svenssonjoel/Z-SIM/firmware/README.md

# README

1. run the setup-submodules script

# Building

1. make        : build LispBM and Z-SIM firmware
2. make flash  : Program onto MCU

# Serial terminal

1. sudo screen /dev/ttyACM0   (or ttyACM1 etc)

#Lisp Interpreter Commands

1. (dcdc-enable)   : enable dcdc buck converter
2. (dcdc-disable)  : disable dcd buck converter 
3. (vsel-set n)    : set vsel bits, n is five bit number
