svenssonjoel/Z-SIM/sp_z_sim.kicad_pcb

## KiCad design sp_z_sim.kicad_pcb (2019-12-05)

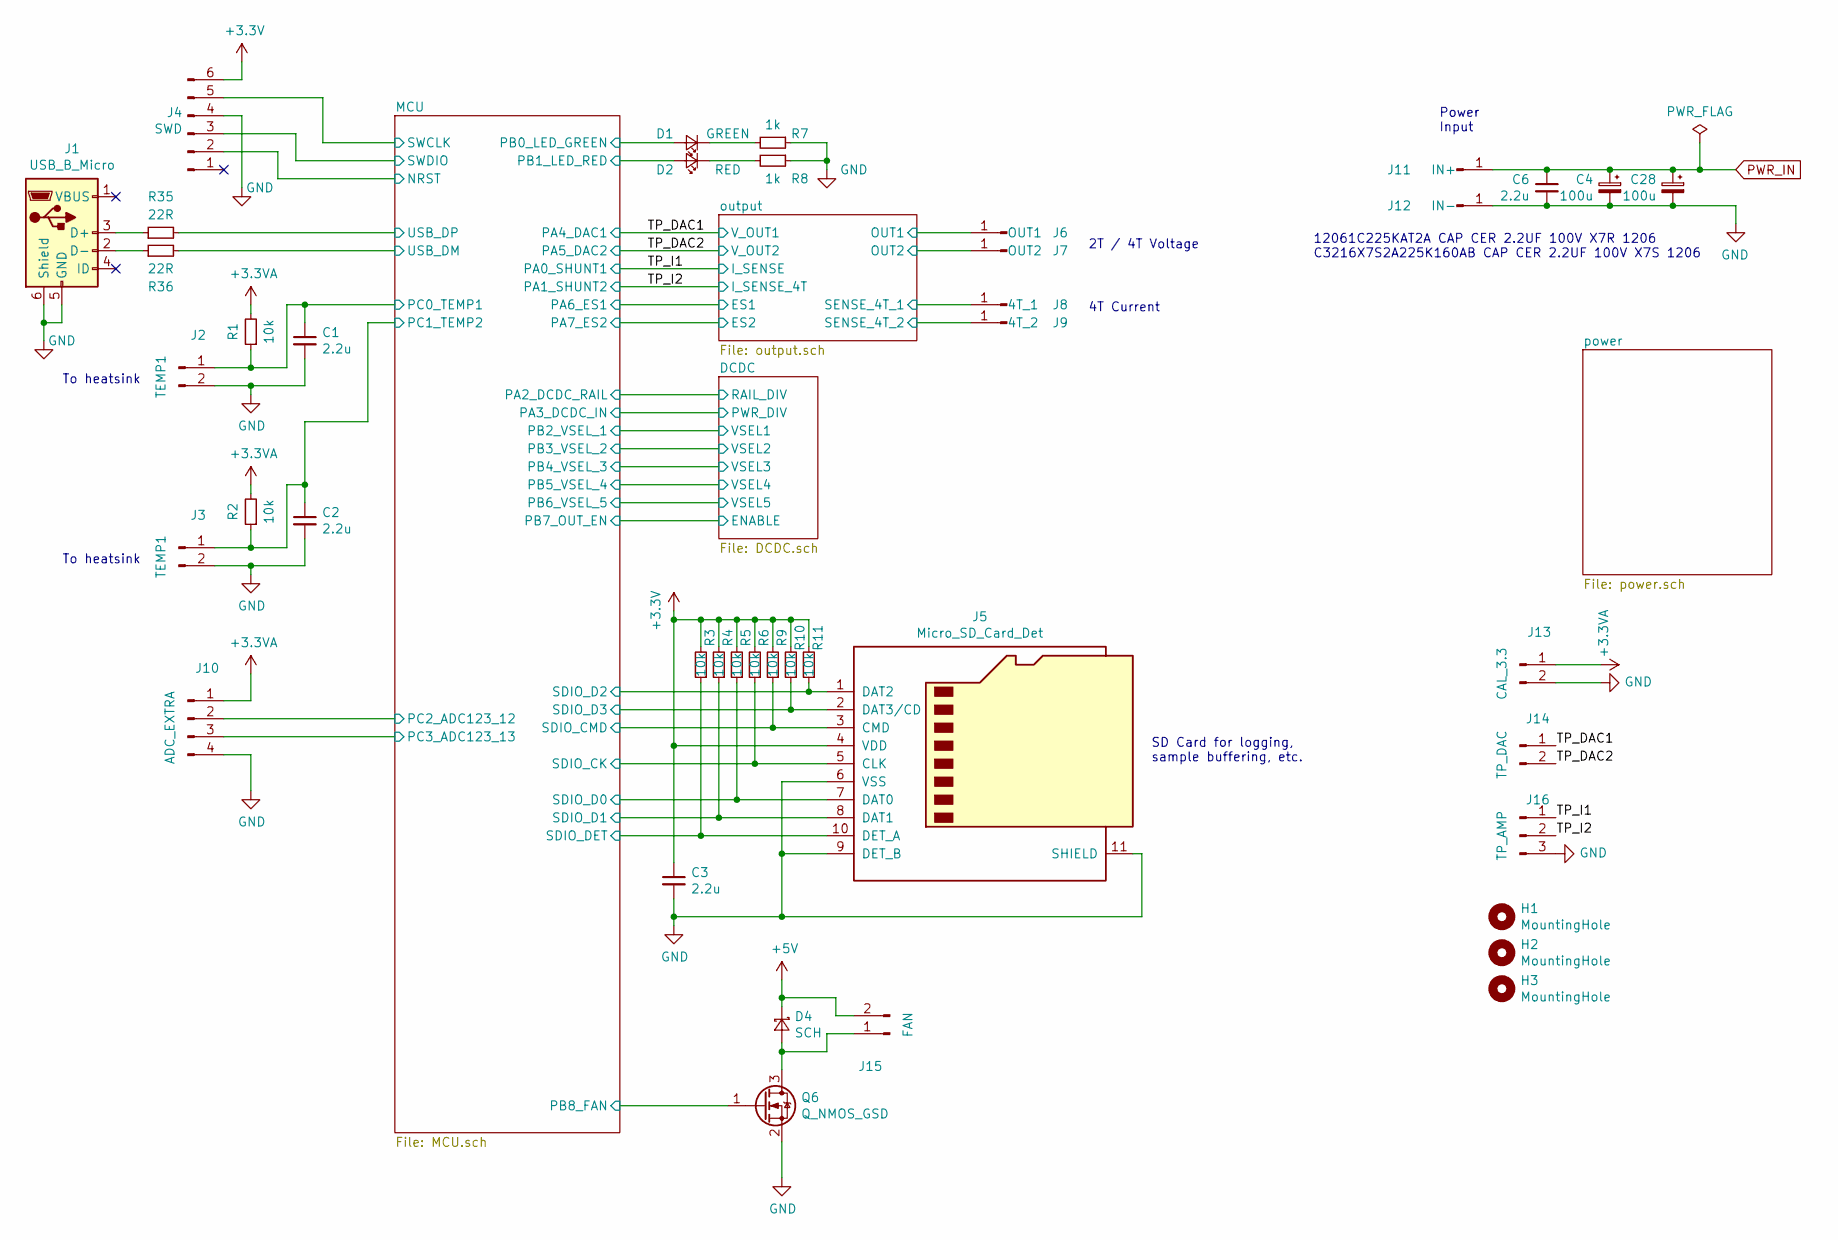
[picture p4: schematic sp_z_sim.sch, Z Sim]

Parts:
C1, C2, C3: 2.2u; C_0603_1608Metric
C4, C28: 100u; CP_Radial_D10.0mm_P5.00mm
C6: 2.2u; C_1206_3216Metric
D1: GREEN; LED_0603_1608Metric
D2: RED; LED_0603_1608Metric
D4: SCH; D_SMA
H1, H2, H3: MountingHole; MountingHole_3.2mm_M3
J1: USB_B_Micro; USB_Micro-B_Molex-105017-0001
J2, J3: TEMP1; JST_PH_B2B-PH-K_1x02_P2.00mm_Vertical
J4: SWD; JST_PH_B6B-PH-K_1x06_P2.00mm_Vertical
J5: Micro_SD_Card_Det; microSD_HC_Hirose_DM3D-SF
J6: OUT1; TestPoint_Pad_4.0x4.0mm
J7: OUT2; TestPoint_Pad_4.0x4.0mm
J8: 4T_1; TestPoint_Pad_4.0x4.0mm
J9: 4T_2; TestPoint_Pad_4.0x4.0mm
J10: ADC_EXTRA; JST_PH_B4B-PH-K_1x04_P2.00mm_Vertical
J11: IN+; TestPoint_Pad_4.0x4.0mm
J12: IN-; TestPoint_Pad_4.0x4.0mm
J13: CAL_3.3; JST_PH_B2B-PH-K_1x02_P2.00mm_Vertical
J14: TP_DAC; JST_PH_B2B-PH-K_1x02_P2.00mm_Vertical
J15: FAN; JST_PH_B2B-PH-K_1x02_P2.00mm_Vertical
J16: TP_AMP; JST_PH_B3B-PH-K_1x03_P2.00mm_Vertical
Q6: Q_NMOS_GSD; SOT-23
R1, R2, R3, R4, R5, R6, R9, R10, R11: 10k; R_0603_1608Metric
R7, R8: 1k; R_0603_1608Metric
R35, R36: 22R; R_0603_1608Metric

Connections:
+3.3VA: J10.1, J13.1, R1.2, R2.2; also elsewhere on the board
+3V3: C3.1, J4.6, J5.4 (VDD), R3.2, R4.2, R5.2, R6.2, R9.2, R10.2, R11.2; also elsewhere on the board
+5V: D4.1 (K), J15.2; also elsewhere on the board
/NRST: J4.2; also elsewhere on the board
/OUT1: J6.1; also elsewhere on the board
/OUT2: J7.1; also elsewhere on the board
/PB0_LED_GREEN: D1.2 (A); also elsewhere on the board
/PB1_LED_RED: D2.2 (A); also elsewhere on the board
/PB8_FAN: Q6.1 (G); also elsewhere on the board
/PC0_TEMP1: C1.1, J2.1, R1.1; also elsewhere on the board
/PC1_TEMP2: C2.1, J3.1, R2.1; also elsewhere on the board
/PC2_ADC123_12: J10.2; also elsewhere on the board
/PC3_ADC123_13: J10.3; also elsewhere on the board
/SDIO_CK: J5.5 (CLK), R6.1; also elsewhere on the board
/SDIO_CMD: J5.3 (CMD), R9.1; also elsewhere on the board
/SDIO_D0: J5.7 (DAT0), R5.1; also elsewhere on the board
/SDIO_D1: J5.8 (DAT1), R4.1; also elsewhere on the board
/SDIO_D2: J5.1 (DAT2), R11.1; also elsewhere on the board
/SDIO_D3: J5.2 (DAT3/CD), R10.1; also elsewhere on the board
/SDIO_DET: J5.10 (DET_A), R3.1; also elsewhere on the board
/SENSE_4T_1: J8.1; also elsewhere on the board
/SENSE_4T_2: J9.1; also elsewhere on the board
/SWCLK: J4.5; also elsewhere on the board
/SWDIO: J4.3; also elsewhere on the board
/TP_DAC1: J14.1; also elsewhere on the board
/TP_DAC2: J14.2; also elsewhere on the board
/TP_I1: J16.1; also elsewhere on the board
/TP_I2: J16.2; also elsewhere on the board
/USB_DM: R36.2; also elsewhere on the board
/USB_DP: R35.2; also elsewhere on the board
GND: C1.2, C2.2, C3.2, C4.2, C6.2, C28.2, J1.5 (GND), J1.6 (Shield), J2.2, J3.2, J4.4, J5.6 (VSS), J5.9 (DET_B), J5.11 (SHIELD), J10.4, J12.1, J13.2, J16.3, Q6.2 (S), R7.1, R8.1; also elsewhere on the board
unnamed: D1.1 (K), R7.2
unnamed: D2.1 (K), R8.2
unnamed: D4.2 (A), J15.1, Q6.3 (D)
unnamed: J1.2 (D-), R36.1
unnamed: J1.3 (D+), R35.1
PWR_IN: C4.1, C6.1, C28.1, J11.1; also elsewhere on the board

Notes on the sheet:
To heatsink
2T / 4T Voltage
4T Current
12061C225KAT2A CAP CER 2.2UF 100V X7R 1206 C3216X7S2A225K160AB CAP CER 2.2UF 100V X7S 1206
Power Input
SD Card for logging, sample buffering, etc.

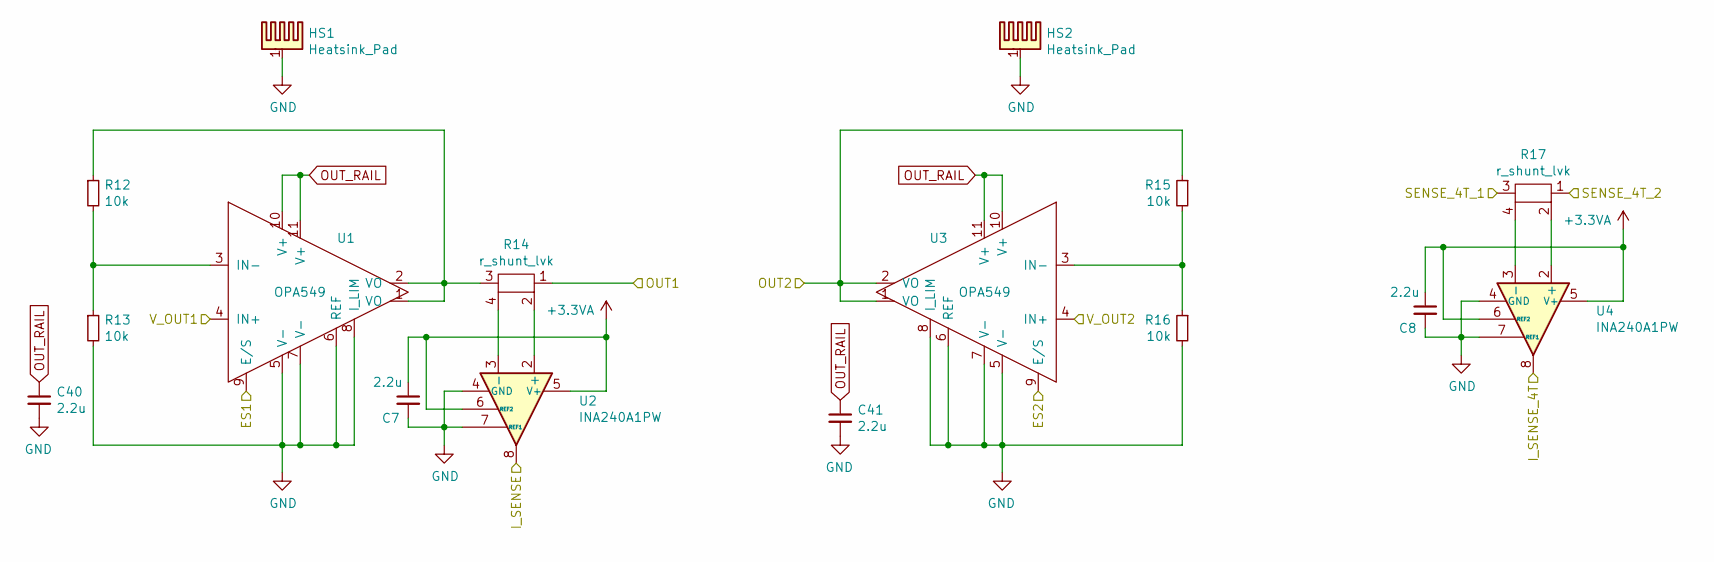
[picture p5: schematic output.sch, Z Sim]

Parts:
C7, C8, C40, C41: 2.2u; C_0603_1608Metric
HS1, HS2: Heatsink_Pad; OMNI-220-18-50-2C
R12, R13, R15, R16: 10k; R_0603_1608Metric
R14, R17: r_shunt_lvk; R_Shunt_Ohmite_LVK24
U1, U3: OPA549; TO-220-11_P3.4x5.08mm_StaggerOdd_Lead4.85mm_Vertical
U2, U4: INA240A1PW; TSSOP-8_4.4x3mm_P0.65mm

Connections:
+3.3VA: C7.1, C8.1, U2.5 (V+), U2.6 (REF2), U4.5 (V+), U4.6 (REF2); also elsewhere on the board
/OUT1: R14.1; also elsewhere on the board
/OUT2: R15.1, U3.1 (VO), U3.2 (VO); also elsewhere on the board
/PA6_ES1: U1.9 (E/S); also elsewhere on the board
/PA7_ES2: U3.9 (E/S); also elsewhere on the board
/SENSE_4T_1: R17.3; also elsewhere on the board
/SENSE_4T_2: R17.1; also elsewhere on the board
/TP_DAC1: U1.4 (IN+); also elsewhere on the board
/TP_DAC2: U3.4 (IN+); also elsewhere on the board
/TP_I1: U2.8; also elsewhere on the board
/TP_I2: U4.8; also elsewhere on the board
GND: C7.2, C8.2, C40.2, C41.2, HS1.1, HS2.1, R13.2, R16.2, U1.5 (V-), U1.6 (REF), U1.7 (V-), U1.8 (I_LIM), U2.1 (GND), U2.4 (GND), U2.7 (REF1), U3.5 (V-), U3.6 (REF), U3.7 (V-), U3.8 (I_LIM), U4.1 (GND), U4.4 (GND), U4.7 (REF1); also elsewhere on the board
unnamed: R12.1, R14.3, U1.1 (VO), U1.2 (VO)
unnamed: R12.2, R13.1, U1.3 (IN-)
unnamed: R14.2, U2.2 (+)
unnamed: R14.4, U2.3 (-)
unnamed: R15.2, R16.1, U3.3 (IN-)
unnamed: R17.2, U4.2 (+)
unnamed: R17.4, U4.3 (-)
OUT_RAIL: C40.1, C41.1, U1.10 (V+), U1.11 (V+), U3.10 (V+), U3.11 (V+); also elsewhere on the board

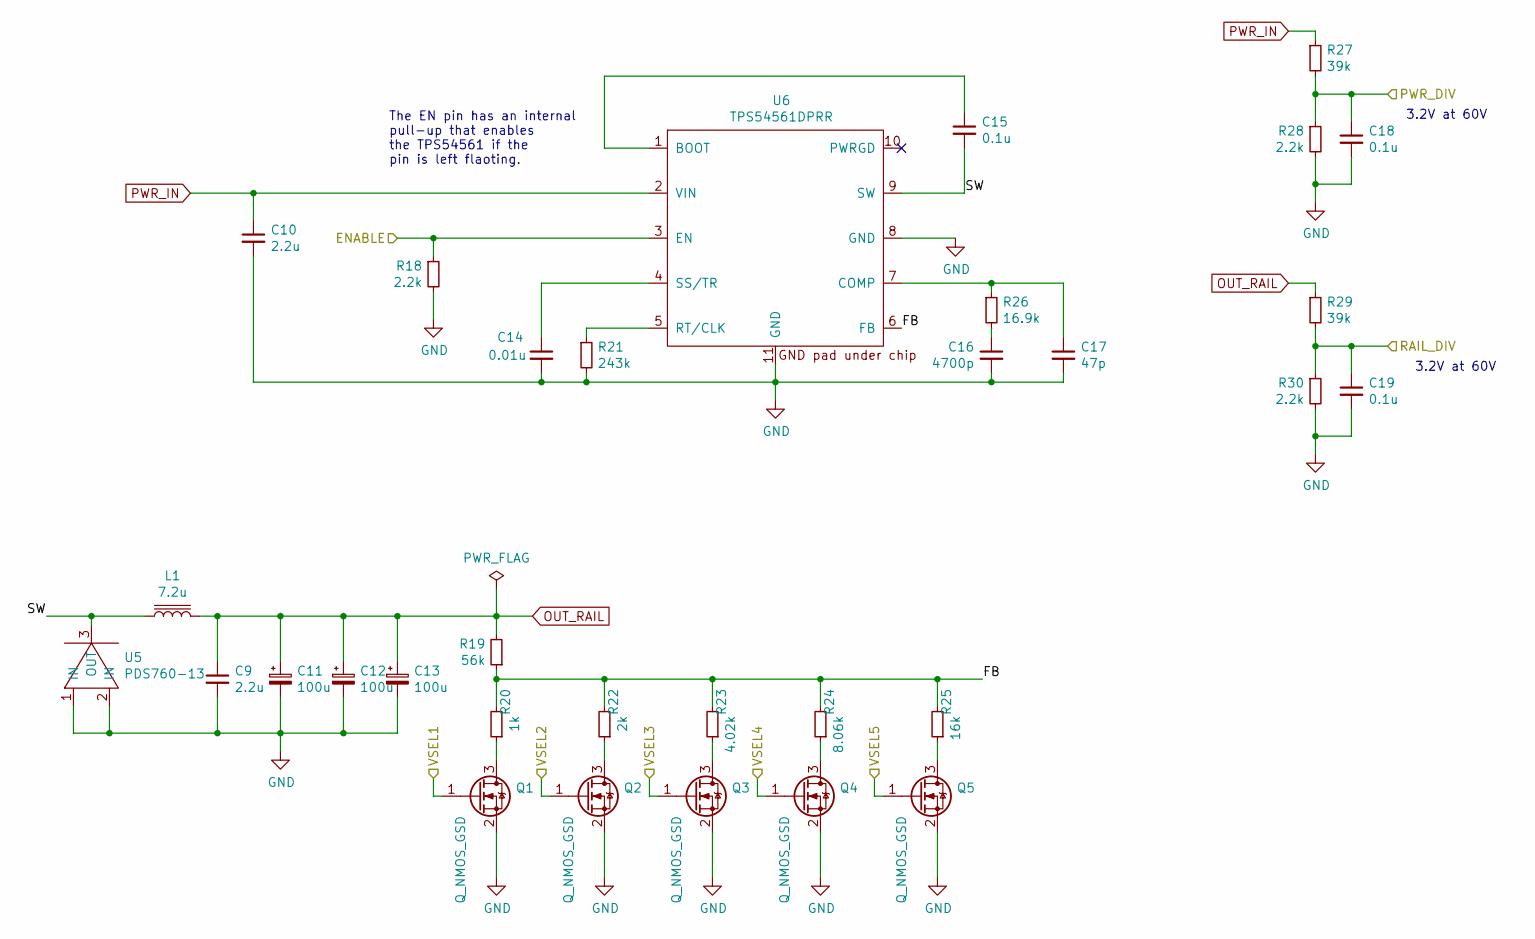
[picture p6: schematic DCDC.sch, Z Sim]

Parts:
C9: 2.2u; C_0603_1608Metric
C10: 2.2u; C_1206_3216Metric
C11, C12, C13: 100u; CP_Radial_D10.0mm_P5.00mm
C14: 0.01u; C_0603_1608Metric
C15, C18, C19: 0.1u; C_0603_1608Metric
C16: 4700p; C_0603_1608Metric
C17: 47p; C_0603_1608Metric
L1: 7.2u; L_12x12mm_H8mm
Q1, Q2, Q3, Q4, Q5: Q_NMOS_GSD; SOT-23
R18, R28, R30: 2.2k; R_0603_1608Metric
R19: 56k; R_0603_1608Metric
R20: 1k; R_0603_1608Metric
R21: 243k; R_0603_1608Metric
R22: 2k; R_0603_1608Metric
R23: 4.02k; R_0603_1608Metric
R24: 8.06k; R_0603_1608Metric
R25: 16k; R_0603_1608Metric
R26: 16.9k; R_0603_1608Metric
R27, R29: 39k; R_0603_1608Metric
U5: PDS760-13; POWERDI5
U6: TPS54561DPRR; TI-DPR

Connections:
/DCDC/FB: R19.1, R20.2, R22.2, R23.2, R24.2, R25.2, U6.6 (FB)
/DCDC/SW: C15.2, L1.1, U5.3 (OUT), U6.9 (SW)
/ENABLE: R18.1, U6.3 (EN); also elsewhere on the board
/PA2_DCDC_RAIL: C19.1, R29.2, R30.1; also elsewhere on the board
/PB2_VSEL_1: Q1.1 (G); also elsewhere on the board
/PB3_VSEL_2: Q2.1 (G); also elsewhere on the board
/PB4_VSEL_3: Q3.1 (G); also elsewhere on the board
/PWR_DIV: C18.1, R27.2, R28.1; also elsewhere on the board
/VSEL4: Q4.1 (G); also elsewhere on the board
/VSEL5: Q5.1 (G); also elsewhere on the board
GND: C9.2, C10.2, C11.2, C12.2, C13.2, C14.2, C16.2, C17.2, C18.2, C19.2, Q1.2 (S), Q2.2 (S), Q3.2 (S), Q4.2 (S), Q5.2 (S), R18.2, R21.2, R28.2, R30.2, U5.1 (IN), U5.2 (IN), U6.8 (GND), U6.11 (GND); also elsewhere on the board
unnamed: C14.1, U6.4 (SS/TR)
unnamed: C15.1, U6.1 (BOOT)
unnamed: C16.1, R26.2
unnamed: C17.1, R26.1, U6.7 (COMP)
unnamed: Q1.3 (D), R20.1
unnamed: Q2.3 (D), R22.1
unnamed: Q3.3 (D), R23.1
unnamed: Q4.3 (D), R24.1
unnamed: Q5.3 (D), R25.1
unnamed: R21.1, U6.5 (RT/CLK)
OUT_RAIL: C9.1, C11.1, C12.1, C13.1, L1.2, R19.2, R29.1; also elsewhere on the board
PWR_IN: C10.1, R27.1, U6.2 (VIN); also elsewhere on the board

Notes on the sheet:
3.2V at 60V
The EN pin has an internal pull-up that enables the TPS54561 if the pin is left flaoting.

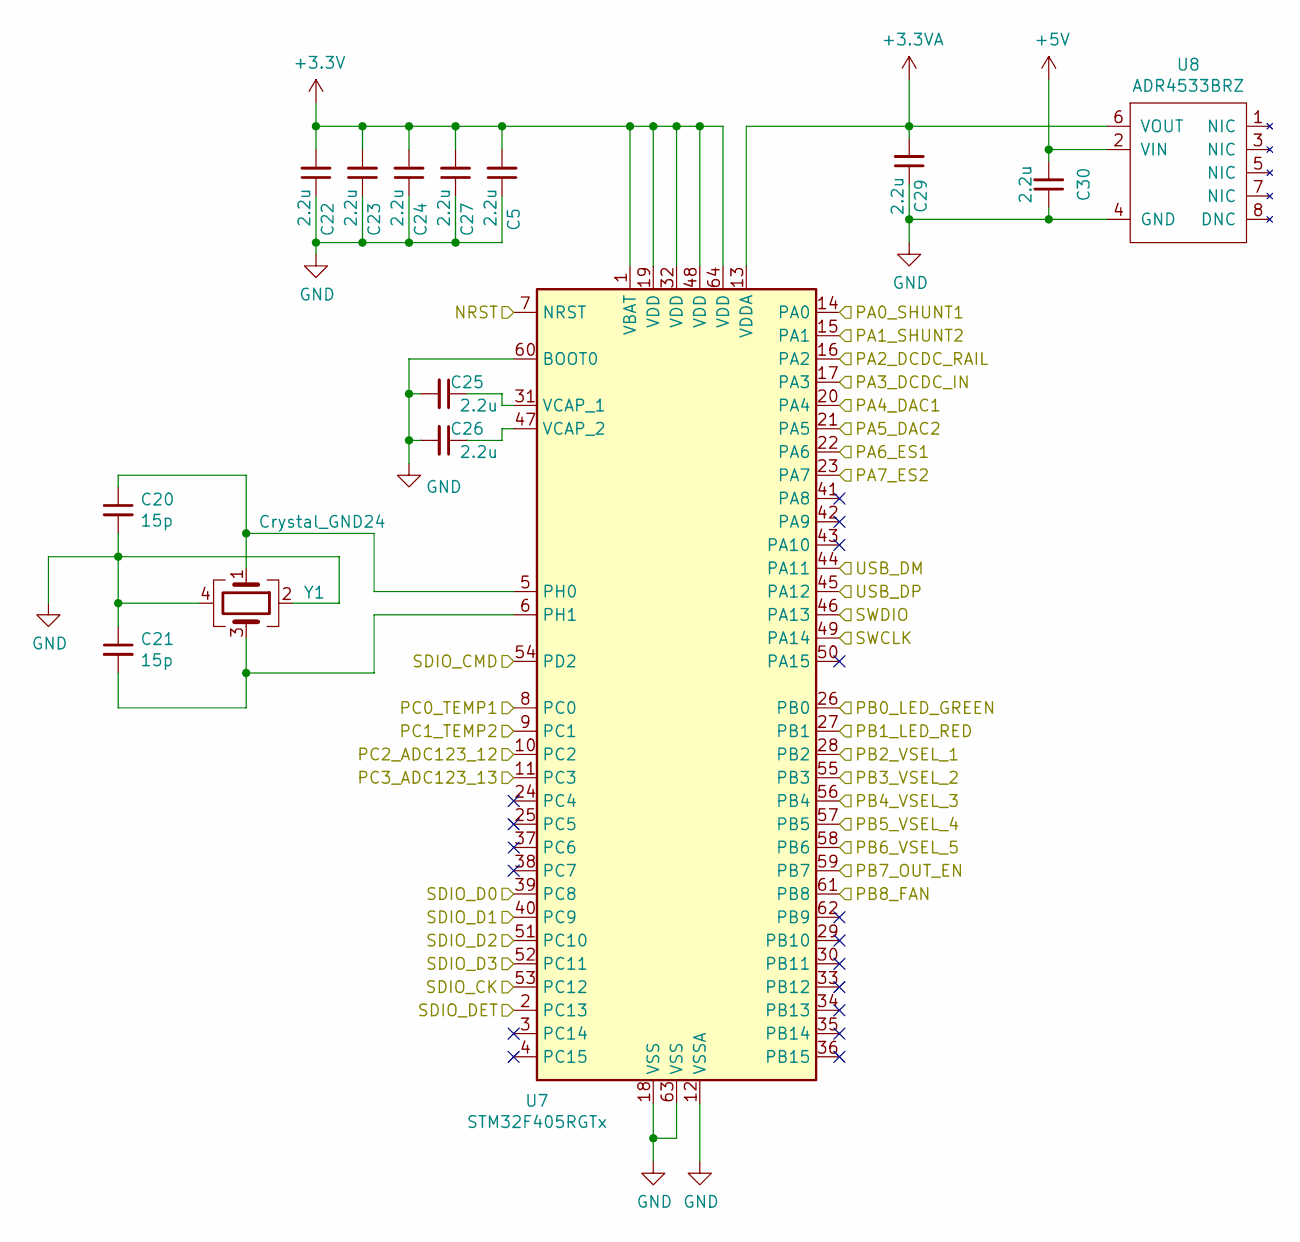
[picture p7: schematic MCU.sch, Z Sim]

Parts:
C5, C22, C23, C24, C25, C26, C27, C29, C30: 2.2u; C_0603_1608Metric
C20, C21: 15p; C_0603_1608Metric
U7: STM32F405RGTx; LQFP-64_10x10mm_P0.5mm
U8: ADR4533BRZ; SOIC-8_3.9x4.9mm_P1.27mm
Y1: Crystal_GND24; Crystal_SMD_Abracon_ABM3C-4Pin_5.0x3.2mm

Connections:
+3.3VA: C29.2, U7.13 (VDDA), U8.6 (VOUT); also elsewhere on the board
+3V3: C5.2, C22.2, C23.2, C24.2, C27.2, U7.1 (VBAT), U7.19 (VDD), U7.32 (VDD), U7.48 (VDD), U7.64 (VDD); also elsewhere on the board
+5V: C30.2, U8.2 (VIN); also elsewhere on the board
/ENABLE: U7.59 (PB7); also elsewhere on the board
/NRST: U7.7 (NRST); also elsewhere on the board
/PA2_DCDC_RAIL: U7.16 (PA2); also elsewhere on the board
/PA6_ES1: U7.22 (PA6); also elsewhere on the board
/PA7_ES2: U7.23 (PA7); also elsewhere on the board
/PB0_LED_GREEN: U7.26 (PB0); also elsewhere on the board
/PB1_LED_RED: U7.27 (PB1); also elsewhere on the board
/PB2_VSEL_1: U7.28 (PB2); also elsewhere on the board
/PB3_VSEL_2: U7.55 (PB3); also elsewhere on the board
/PB4_VSEL_3: U7.56 (PB4); also elsewhere on the board
/PB8_FAN: U7.61 (PB8); also elsewhere on the board
/PC0_TEMP1: U7.8 (PC0); also elsewhere on the board
/PC1_TEMP2: U7.9 (PC1); also elsewhere on the board
/PC2_ADC123_12: U7.10 (PC2); also elsewhere on the board
/PC3_ADC123_13: U7.11 (PC3); also elsewhere on the board
/PWR_DIV: U7.17 (PA3); also elsewhere on the board
/SDIO_CK: U7.53 (PC12); also elsewhere on the board
/SDIO_CMD: U7.54 (PD2); also elsewhere on the board
/SDIO_D0: U7.39 (PC8); also elsewhere on the board
/SDIO_D1: U7.40 (PC9); also elsewhere on the board
/SDIO_D2: U7.51 (PC10); also elsewhere on the board
/SDIO_D3: U7.52 (PC11); also elsewhere on the board
/SDIO_DET: U7.2 (PC13); also elsewhere on the board
/SWCLK: U7.49 (PA14); also elsewhere on the board
/SWDIO: U7.46 (PA13); also elsewhere on the board
/TP_DAC1: U7.20 (PA4); also elsewhere on the board
/TP_DAC2: U7.21 (PA5); also elsewhere on the board
/TP_I1: U7.14 (PA0); also elsewhere on the board
/TP_I2: U7.15 (PA1); also elsewhere on the board
/USB_DM: U7.44 (PA11); also elsewhere on the board
/USB_DP: U7.45 (PA12); also elsewhere on the board
/VSEL4: U7.57 (PB5); also elsewhere on the board
/VSEL5: U7.58 (PB6); also elsewhere on the board
GND: C5.1, C20.2, C21.1, C22.1, C23.1, C24.1, C25.2, C26.2, C27.1, C29.1, C30.1, U7.12 (VSSA), U7.18 (VSS), U7.60 (BOOT0), U7.63 (VSS), U8.4 (GND), Y1.2, Y1.4; also elsewhere on the board
unnamed: C20.1, U7.5 (PH0), Y1.1
unnamed: C21.2, U7.6 (PH1), Y1.3
unnamed: C25.1, U7.31 (VCAP_1)
unnamed: C26.1, U7.47 (VCAP_2)

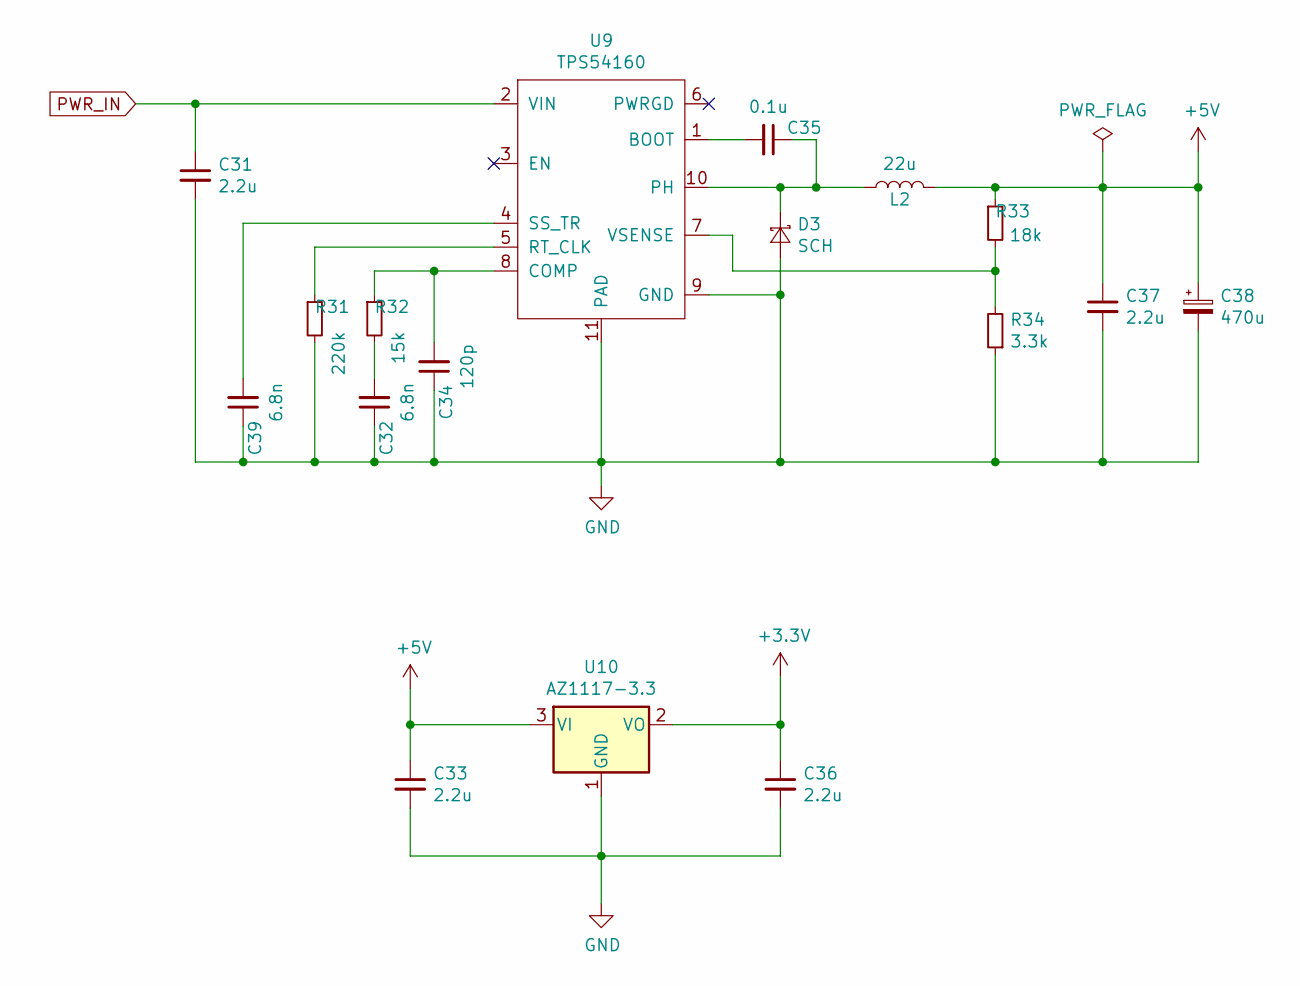
[picture p8: schematic power.sch, Z Sim]

Parts:
C31, C33, C36, C37: 2.2u; C_1206_3216Metric
C32, C39: 6.8n; C_0603_1608Metric
C34: 120p; C_0603_1608Metric
C35: 0.1u; C_0603_1608Metric
C38: 470u; CP_Radial_D10.0mm_P5.00mm
D3: SCH; D_SMA
L2: 22u; L_Taiyo-Yuden_NR-60xx_HandSoldering
R31: 220k; R_0603_1608Metric
R32: 15k; R_0603_1608Metric
R33: 18k; R_0603_1608Metric
R34: 3.3k; R_0603_1608Metric
U9: TPS54160; MSOP-10-1EP_3x3mm_P0.5mm_EP1.68x1.88mm
U10: AZ1117-3.3; SOT-223

Connections:
+3V3: C36.1, U10.2 (VO); also elsewhere on the board
+5V: C33.1, C37.1, C38.1, L2.2, R33.1, U10.3 (VI); also elsewhere on the board
GND: C31.2, C32.1, C33.2, C34.1, C36.2, C37.2, C38.2, C39.1, D3.2 (A), R31.2, R34.1, U9.9 (GND), U9.11 (PAD), U10.1 (GND); also elsewhere on the board
unnamed: C32.2, R32.2
unnamed: C34.2, R32.1, U9.8 (COMP)
unnamed: C35.1, D3.1 (K), L2.1, U9.10 (PH)
unnamed: C35.2, U9.1 (BOOT)
unnamed: C39.2, U9.4 (SS_TR)
unnamed: R31.1, U9.5 (RT_CLK)
unnamed: R33.2, R34.2, U9.7 (VSENSE)
PWR_IN: C31.1, U9.2 (VIN); also elsewhere on the board

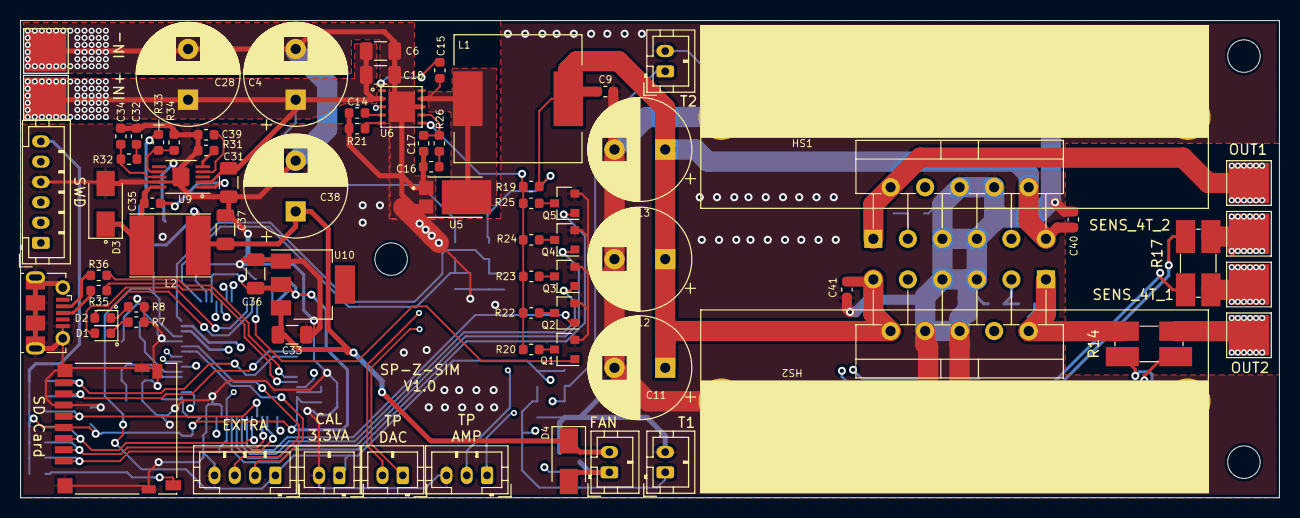
[picture p9: board sp_z_sim.kicad_pcb from above]

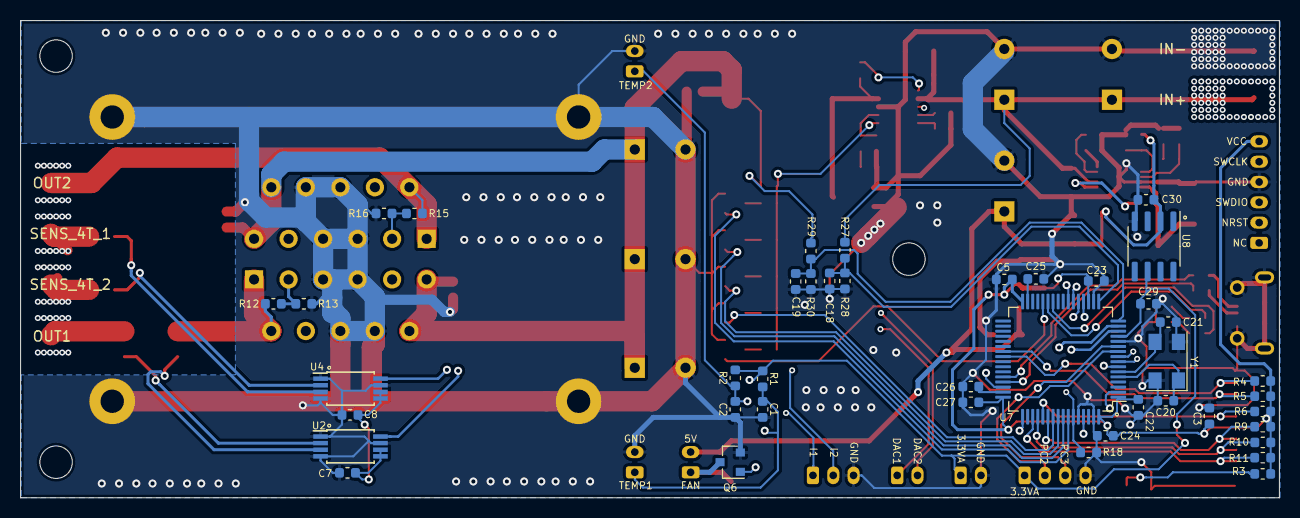
[picture p10: board sp_z_sim.kicad_pcb from below]

Board: 4 copper layers, 124.0 x 47.0 mm, 121 parts (42 on the bottom side), 78 nets.
