svenssonjoel/Z-SIM/firmware/main.c

/*
    Copyright 2019 Joel Svensson	svenssonjoel@yahoo.se

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
    You should have received a copy of the GNU General Public License
    along with this program.  If not, see <http://www.gnu.org/licenses/>.
*/

#include <stdio.h>
#include <string.h>
#include <stdlib.h>
#include <ctype.h>
#include <math.h>

#include "ch.h"
#include "hal.h"
#include "usbcfg.h"
#include "chprintf.h"

#include "led.h"
#include "repl.h"



int main(void) {
  halInit();
  chSysInit();

  dcdc_init();
  led_init();

	
  sduObjectInit(&SDU1);
  sduStart(&SDU1, &serusbcfg);

  /*
   * Activates the USB driver and then the USB bus pull-up on D+.
   * Note, a delay is inserted in order to not have to disconnect the cable
   * after a reset.
   */
  usbDisconnectBus(serusbcfg.usbp);
  chThdSleepMilliseconds(1500);
  usbStart(serusbcfg.usbp, &usbcfg);
  usbConnectBus(serusbcfg.usbp);
  chThdSleepMilliseconds(500);
        
  createReplThread((BaseSequentialStream *)&SDU1);

  /*
   *  Main thread activity...
   */
  while (true) {
	  
    chThdSleepMilliseconds(1000);
  }
}
