svenssonjoel/Z-SIM/firmware/dcdc.c

/*
    Copyright 2019 Joel Svensson	svenssonjoel@yahoo.se

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
    You should have received a copy of the GNU General Public License
    along with this program.  If not, see <http://www.gnu.org/licenses/>.
*/

#include "dcdc.h"

static unsigned char dcdc_vsel; 

static adcsample_t samples[2];

static unsigned int input_vsense = 0;
static unsigned int rail_vsense = 0; 

static void adccallback(ADCDriver *adcp) {

  (void) adcp;
  //(void) buffer;
  //(void) n;

  // Hack... TODO: figure out how to do this.. 
  input_vsense = samples[0];
  rail_vsense  = samples[1]; 
  
}

static const ADCConversionGroup adcgrpcfg = {
  TRUE, // TODO: Lookup what this means
  2,    // Number of ADC channels
  adccallback, // the callback above
  0, // error callback
  0, // CR1
  ADC_CR2_SWSTART, // CR2
  0, // SMPR1 (CHANNEL X sampling time for x >= 10) 
  ADC_SMPR2_SMP_AN2(ADC_SAMPLE_56) |
  ADC_SMPR2_SMP_AN3(ADC_SAMPLE_56), // SMPR2   ??? (CHANNEL X sampling time for x < 10)
  0, // watchdog htr
  0, // watchdog ltr
  2, // SQR1: Number of conversions
  0, // SQR2: Sequence for channel >= 10 
  ADC_SQR3_SQ2_N(ADC_CHANNEL_IN3) | ADC_SQR3_SQ1_N(ADC_CHANNEL_IN2)
}; 
  
  
 

void dcdc_init(void) {

  dcdc_vsel = 1; 

  // Analog inputs
  palSetPadMode(INPUT_VSENSE_GPIO,
		INPUT_VSENSE_PIN,
		PAL_MODE_INPUT_ANALOG);
  palSetPadMode(RAIL_VSENSE_GPIO,
		RAIL_VSENSE_PIN,
		PAL_MODE_INPUT_ANALOG);
  // TODO: Enable ADC (Cannot find any "understandable" example)
  // 
  // ADC123_IN2 - GPIOA pin 2
  // ADC123_IN3 - GPIOA pin 3

  adcStart(&ADCD1, NULL);
  adcStartConversion(&ADCD1, &adcgrpcfg, samples, 2);
  
  // Digital outputs
  palSetPadMode(VSEL_GPIO,
		VSEL_1_PIN,
		PAL_MODE_OUTPUT_PUSHPULL |
		PAL_STM32_OSPEED_HIGHEST);
  palSetPadMode(VSEL_GPIO,
		VSEL_2_PIN,
		PAL_MODE_OUTPUT_PUSHPULL |
		PAL_STM32_OSPEED_HIGHEST);
  palSetPadMode(VSEL_GPIO,
		VSEL_3_PIN,
		PAL_MODE_OUTPUT_PUSHPULL |
		PAL_STM32_OSPEED_HIGHEST);
  palSetPadMode(VSEL_GPIO,
		VSEL_4_PIN,
		PAL_MODE_OUTPUT_PUSHPULL |
		PAL_STM32_OSPEED_HIGHEST);
  palSetPadMode(VSEL_GPIO,
		VSEL_5_PIN,
		PAL_MODE_OUTPUT_PUSHPULL |
		PAL_STM32_OSPEED_HIGHEST);
  

  palSetPadMode(DCDC_OUTPUT_ENABLE_GPIO,
		DCDC_OUTPUT_ENABLE_PIN,
		PAL_MODE_OUTPUT_PUSHPULL |
		PAL_STM32_OSPEED_HIGHEST);
  palWritePad(DCDC_OUTPUT_ENABLE_GPIO,
	      DCDC_OUTPUT_ENABLE_PIN,
	      0);
  

  palWritePad(VSEL_GPIO, VSEL_1_PIN, dcdc_vsel & 1);
  palWritePad(VSEL_GPIO, VSEL_2_PIN, (dcdc_vsel >> 1) & 1);
  palWritePad(VSEL_GPIO, VSEL_3_PIN, (dcdc_vsel >> 2) & 1);
  palWritePad(VSEL_GPIO, VSEL_4_PIN, (dcdc_vsel >> 3) & 1);
  palWritePad(VSEL_GPIO, VSEL_5_PIN, (dcdc_vsel >> 4) & 1);

}

bool dcdc_vsel_set(unsigned char vsel) {

  if (!(vsel & 0x1F)) return false;

  dcdc_vsel = vsel;

  palWritePad(VSEL_GPIO, VSEL_1_PIN, dcdc_vsel & 1);
  palWritePad(VSEL_GPIO, VSEL_2_PIN, (dcdc_vsel >> 1) & 1);
  palWritePad(VSEL_GPIO, VSEL_3_PIN, (dcdc_vsel >> 2) & 1);
  palWritePad(VSEL_GPIO, VSEL_4_PIN, (dcdc_vsel >> 3) & 1);
  palWritePad(VSEL_GPIO, VSEL_5_PIN, (dcdc_vsel >> 4) & 1);

  return true; 
}


bool dcdc_enable(void) {

  if (!(dcdc_vsel & 0x1F)) return false;

  palWritePad(DCDC_OUTPUT_ENABLE_GPIO,
	      DCDC_OUTPUT_ENABLE_PIN,
	      1);
  
  return true; 
}

void dcdc_disable(void) {
  
  palWritePad(DCDC_OUTPUT_ENABLE_GPIO,
	      DCDC_OUTPUT_ENABLE_PIN,
	      0);
  
}
