svenssonjoel/Z-SIM/(commit log)

2019-10-21 initial commit: work in progress
    [DCDC.sch, MCU.sch, output.sch, sp_z_sim.kicad_pcb, sp_z_sim.sch]
2019-10-22 Finished first version of schematic
    [DCDC.sch, MCU.sch, output.sch, power.sch, sp_z_sim.kicad_pcb, sp_z_sim.sch]
2019-10-23 preparation for routing and adding kylfläns
    [output.sch, sp_z_sim.kicad_pcb, sp_z_sim.sch]
2019-10-24 Schematic updates, added 3D models and started routing
    [DCDC.sch, MCU.sch, output.sch, sp_z_sim.kicad_pcb, sp_z_sim.sch]
2019-10-24 Some routing updates
    [sp_z_sim.kicad_pcb]
2019-11-04 Finished routing and added some 3D models
    [DCDC.sch, MCU.sch, sp_z_sim.kicad_pcb, sp_z_sim.sch]
2019-11-05 Updated heatsink footprint
    [sp_z_sim.kicad_pcb]
2019-11-05 Updated solder mask settings
    [sp_z_sim.kicad_pcb]
2019-11-05 Added PCB name to silkscreen
    [sp_z_sim.kicad_pcb]
2019-11-05 almost done with bom. there are some issues
    [DCDC.sch, MCU.sch, output.sch, power.sch, sp_z_sim.sch]
2019-11-07 Added testpoints, changed connectors, changed shunts
    [output.sch, sp_z_sim.kicad_pcb, sp_z_sim.sch]
2019-11-08 Finished routing and added gerber files
    [sp_z_sim.kicad_pcb]
2019-11-18 added new resistances for the resistance ladder-thingy
    [DCDC.sch]
2019-11-18 all components now have an OrderN in the matrix
    [output.sch, sp_z_sim.sch]
2019-11-18 Changed fan mosfet part number
    [sp_z_sim.kicad_pcb, sp_z_sim.sch]
2019-11-22 tweak component matrix
    [DCDC.sch]
2019-12-05 moved around text on fab layer
    [sp_z_sim.kicad_pcb]
2019-12-15 starting with setyup of a firmware directory and adding some essentials. No Z-Sim is complete without a Lisp interpreter.
    [STM32L4+.ods, stm_spc56ec74a256s_spc56ec74_minimodule_debug_jtag.cfg, stm_xpc560b64_minimodule_debug_jtag.cfg, stm_xpc560b_spc560d40_minimodule_debug_jtag.cfg, stm_xpc560p_minimodule_40mhz_debug_jtag.cfg, stm_xpc563m64_minimodule_debug_jtag.cfg, stm_xpc564a_spc564a70_minimodule_debug_jtag.cfg, stm_xpc56el_minimodule_lockstep_debug_jtag.cfg]
2019-12-15 added flash rule to makefile
    [stm32f407g.cfg]
2019-12-15 small tweak to openocd config file
    [stm32f407g.cfg]
2019-12-15 started construction of a driver for the dcdc block
